tbitson/Teensy-GEP/User Documentation/User Guide/Doc Resources/IMG_0637D.jpeg

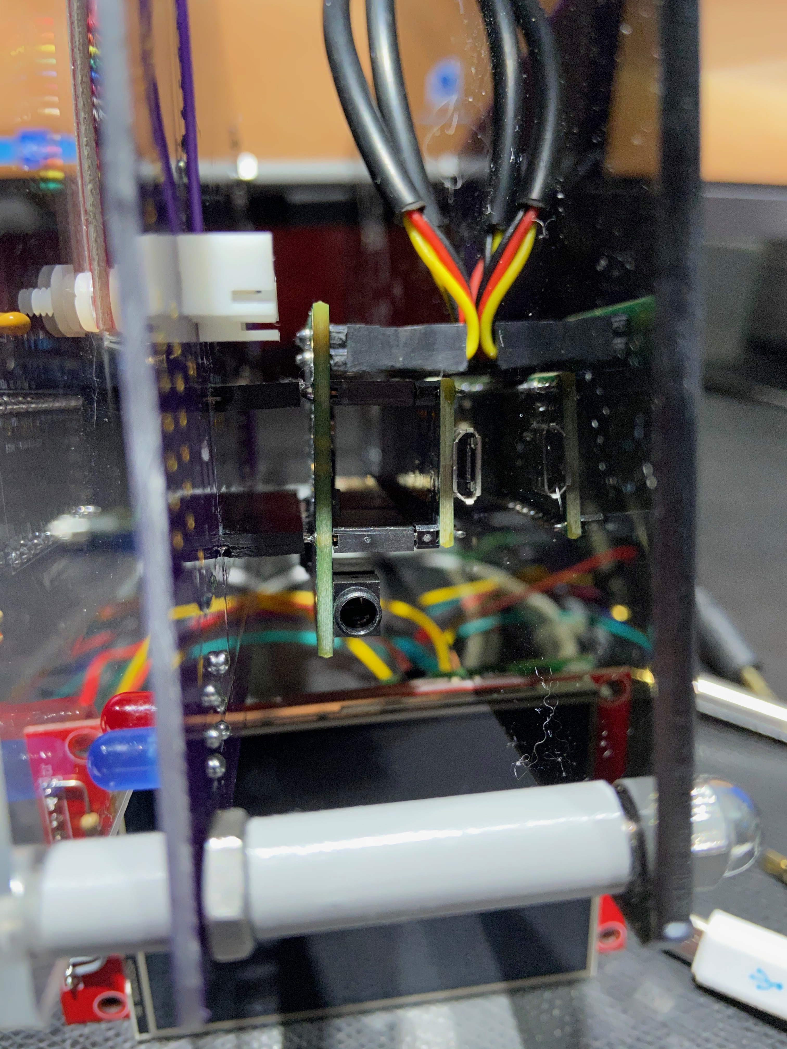
User Documentation/User Guide/Doc Resources/IMG_0637D.jpeg
