tbitson/Teensy-GEP/User Documentation/User Guide/Doc Resources/IMG_0635D.jpeg

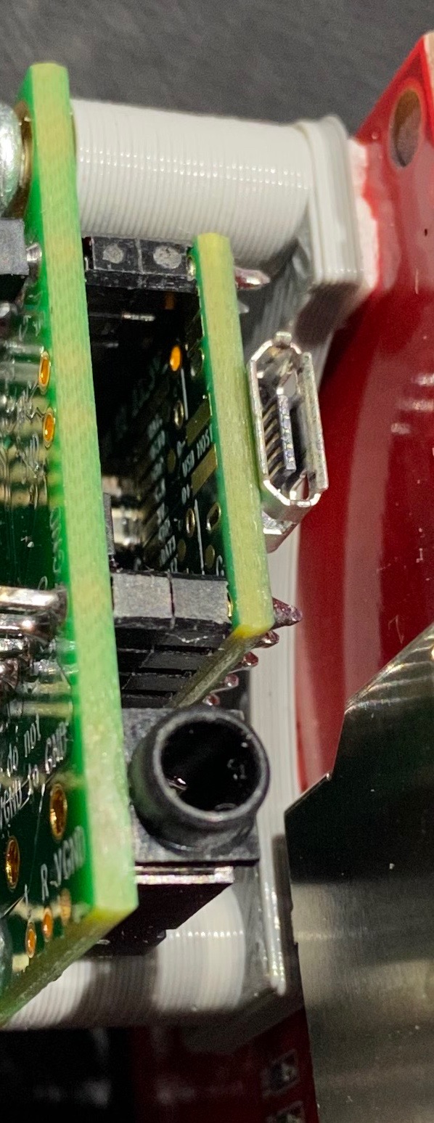
User Documentation/User Guide/Doc Resources/IMG_0635D.jpeg
