tbitson/Teensy-GEP/README.md

# Teensy-GEP
 Teensy Guitar Effects Processor
