tbitson/Teensy-GEP/Audio Shield Docs & Tools/Audio GUI Tool (modified)/README.md

This version of the audio tools includes an
added 8-channel mixer that is not part of the
Teensy Audio Library distribution. The cooresponding
audio library is included the GEP software folder
