tbitson/Teensy-GEP/Audio Shield Docs & Tools/Audio Lib Docs/8.6 FreeverbStereo Function.md

AudioEffectFreeverbStereo
Summary
High quality stereo Reverb effect, based on Freeverb by Jezar at Dreampoint.

Teensy 3.5 or 3.6 required to run stereo version.

Audio Connections
Port	Purpose
In 0	Input
Out 0	Left Output
Out 1	Right Output
Functions
roomsize(amount);
Sets the amount of reverberant echo or apparent room size, from 0 (smallest) to 1.0 (largest);
damping(amount);
Sets the damping factor, from 0 to 1.0. More damping causes higher frequency echo to decay, creating a softer sound, similar to a large room filled with people or materials which absorb some sound as it travels between reflecting surfaces. Lower damping simulates a harsher reverberant field.
Examples
File > Examples > Audio > Effects > Freeverb_Stereo
Notes
Freeverb mono consumes about 18% of the CPU time on Teensy 3.6 and requires about 45K of RAM.

Teensy 3.2 does not have enough RAM to run this effect while playing WAV file and implementing USB Serial.
