tbitson/Teensy-GEP/Audio Shield Docs & Tools/Audio Lib Docs/8.8 Multiply Function.md

AudioEffectMultiply
Summary
Multiply two signals together, useful for amplitude modulation or "voltage controlled amplification".

56 Hz and 1 kHz sine waves multiplied.

Audio Connections
Port	Purpose
In 0	Signal Input
In 1	Signal Input
Out 0	Signal with Envelope Applied
Functions
There are no functions to call from the Arduino sketch. This object simply multiplies the 2 signals to create a continuous output

Notes
