tbitson/Teensy-GEP/Reference Docs/Teensy Pinout Comparison.xlsx

Physical | Teensy 3.2 |  | Teensy 3.6 |  | Teensy 4.0 |  | Audio Sheild |  | 3 to 4 swap |  | LCD Connections |  |  |  | GEP Connections
Pin | I/O # | Pri Func | I/O # | Pri Func | I/O # | Pri Func | Rev c | Rev D | Rev D |  | 3.x | 4.0 | I/O # | Pri Func | 3.x | 4.0
1 |  | GND |  |  |  |  |  |  |  |  | GND | GND
2 | 0 | RX1 | 0 |  |  |  |  |  |  |  |  |  | 0 | D0/RX1 | Tuner Switch
3 | 1 | TX1 | 1 |  |  |  |  |  |  |  |  |  | 1 | D1/TX1 | Enc1 Pin 1
4 | 2 | D2 | 2 |  |  |  |  |  |  |  |  |  | 2 | D2 | Enc1 Pin 2
5 | 3 | D3 | 3 |  |  |  |  |  |  |  |  |  | 3 | D3 | Test LED
6 | 4 | D4 | 4 |  |  |  |  |  |  |  |  |  | 4 | D4 | Enc 2 Pin 1
7 | 5 | D5 | 5 |  |  |  |  |  |  |  |  | TFT_DC | 5 | D5 | Enc2 Pin 2 | TFT_DC
8 | 6 | D6 | 6 |  |  |  | SRAM CS | SRAM CS | NC |  |  |  | 6 | D6 | Audio Board
9 | 7 | D7 | 7 |  |  |  | SPI DI | DIN | 7 to 11 |  |  |  | 7 | D7 | Audio Board
10 | 8 | D8 | 8 |  |  |  |  | DOUT |  | from 8 | TS_CS |  | 8 | D8 | TS_CS
11 | 9 | D9 | 9 |  |  |  | BCLK |  | 9 to 21 |  |  | TS_CS | 9 | D9 | Audio Board | TS_CS
12 | 10 | SPI CS | 10 |  |  |  | SD CS | SD CS | NC |  |  |  | 10 | SPI CS | Audio Board
13 | 11 | SPI DO | 11 |  |  |  | MCLK | SPI DI | 11 to 23 |  | TFT_MOSI | TFT_MOSI | 11 | SPI DO | TFT_MOSI | TFT_MOSI
14 | 12 | SPI DI | 12 |  |  |  | SPI DO | SPI DO | NC |  | TFT_SDO | TFT_SDO | 12 | SPI DI | TFT_SDO | TFT_SDO
15 | 13 | SPI SCK | 13 |  |  |  | DOUT | SCLK | 13 to 8 |  | TFT_SCK | TFT_SCK | 13 | SPI SCK | TFT_SCK | TFT_SCK
16 | 14 | A0 | 14 |  |  |  | SCLK |  | 14 to 13 |  |  | TFT_CS | 14 | A0 | Audio Board | TFT_CS
17 | 15 | A1 | 15 |  |  |  | Pot V | Pot V | NC |  |  |  | 15 | A1 | Wah-Wah Pot
18 | 16 | A2 | 16 |  |  |  |  |  | --- |  | TS_IRQ* | TS_IRQ* | 16 | A2 | Mix Pot | TS_IRQ
19 | 17 | A3 | 17 |  |  |  |  |  | --- |  |  |  | 17 | A3 | Save Switch
20 | 18 | A4 | 18 |  |  |  | SDA | SDA | NC |  |  |  | 18 | A4 | I2C
21 | 19 | A5 | 19 |  |  |  | SCL | SCL | NC |  |  |  | 19 | A5 | I2C
22 | 20 | A6 | 20 |  |  |  |  | LRCLK |  | from 23 | TFT_DC |  | 20 | A6 | TFT_DC
23 | 21 | A7 | 21 |  |  |  |  | BCLK |  | from 9 | TFT_CS |  | 21 | A7 | TFT_CS
24 | 22 | A8 | 22 |  |  |  | DIN |  | 22 to 7 |  |  |  | 22 | A8 | Audio Board
25 | 23 | A9 | 23 |  |  |  | LRCLK | MCLK | 23 to 20 |  |  |  | 23 | A9 | Audio Board
26 |  | 3.3V |  |  |  |  | 3.3V | 3.3V |  |  | TFT_VCC | TFT_VCC
27 |  | AGND |  |  |  |  | AGND | AGND
28 |  | Vin |  |  |  |  |  |  |  |  | TFT_LED | TFT_LED | Thru 100Ω resistor | TFT_LED | TFT_LED
 |  |  |  |  |  |  | 13 | 13 |  |  | TFT_RESET | TFT_RESET | 255 | TFT_RESET | TFT_RESET
 |  |  |  |  |  |  |  |  |  |  | * = optional
3.x LCD Defines |  |  | 4.0 LCD Defines |  |  |  |  |  |  | LCD Connections
No Audio Board |  |  |  |  |  |  |  |  | Phys Pin | Label | LCD Func | Teensy 3.x Pin | Teensy 4.0 Pin |  |  |  | // T_DO: connected to TFT_SDO on the screen
#define TS_IRQ 16 |  |  | With Audio Board |  |  |  |  |  | 1 | VCC | +3.3V | +3.3 | +3.3 |  |  |  | // T_DIN: connected to TFT_MOSI on the screen
#define TS_CS 8 |  |  | // Screen |  |  |  |  |  | 2 | GND | GND | GND | GND |  |  |  | // T_CLK: connected to TFT_SCK on the screen
// Screen |  |  | #define TFT_DC 5 |  |  |  |  |  | 3 | CS | TFT_CS | 21 | 14
#define TFT_SDO 12 |  |  | #define TFT_CS 14 |  |  |  |  |  | 4 | RESET | +3.3V | +3.3 | +3.3
#define TFT_SCK 14 |  |  | #define TFT_SDO 12 |  |  |  |  |  | 5 | DC | TFT_DC | 20 | 5
#define TFT_MOSI 7 |  |  | #define TFT_SCK 13 |  |  |  |  |  | 6 | SDI | TFT_SDI | 7 | 11
#define TFT_DC 20 |  |  | #define TFT_MOSI 11 |  |  |  |  |  | 7 | SCK | TFT_SCK | 14 | 13
#define TFT_RST 255 |  |  | #define TFT_RST 255 |  |  |  |  |  | 8 | LED | LED Power | 100Ω to +5v | 100Ω to +5v
#define TFT_CS 21 |  |  |  |  |  |  |  |  | 9 | SDO | TFT_SDO | 12 | 12
 |  |  | // Touch |  |  |  |  |  | 10 | T_CLK | TS_CLK | 14* | 13*
Teensy GEP |  |  | #define TS_IRQ 16 |  |  |  |  |  | 11 | T_CS | TS_CS | 8 | 9
#define TFT_DC 20 |  |  | #define TS_CS 9 |  |  |  |  |  | 12 | T_DIN | TS_DIN | 11* | 11*
#define TFT_CS 21 |  |  |  |  |  |  |  |  | 13 | T_DO | TS_DO | 12* | 12*
#define TFT_RST 255 |  |  |  |  |  |  |  |  | 14 | T_IRQ | TS_IRQ (Optional) | 16 | 16
#define TFT_MOSI 7
#define TFT_SCLK 14 |  |  |  |  |  |  |  |  |  |  |  | * shared pin on Teensy
#define TFT_MISO 12
#define TS_CS
#define TS_IRG
