tbitson/Teensy-GEP/GEP Hardware/Hardware Design Files/Teensy Audio Pin Map.xlsx

Sheet: Sheet1_2
 | Teensy Pedal Pin assignment
Pin | Description | opt/unused | Comments
 | Encoder / RG led |  |  | Row1 | Type | Connected to | Opt/unused | Row2 | Type | Connected to | Opt/unused
24 | ENC_SW | no | D in pullup | GND |  |  |  | Vin
25 | ENC_A | no | D in pullup | 0 | D | #N/A | #N/A | A GND | OUT | #N/A | #N/A
26 | ENC_B | no | D in pullup | 1 | D | #N/A | #N/A | 3.3V 250 ma | OUT | #N/A | #N/A
29 | ENC_Rled | y | PWM | 2 | D | #N/A | #N/A | 23 | A | DACL/ADCL i2s | no
30 | ENC_Gled | y | PWM | 3 | D | #N/A | #N/A | 22 | A | MOSI i2s | no
 | Pots |  |  | 4 | D | #N/A | #N/A | 21 | A | TFT_CS | no
36 | Pot1 | no | analog in | 5 | D | #N/A | #N/A | 20 | A | TFT_DC | no
37 | Pot2 | no | analog in | 6 | D | #N/A | #N/A | 19 | A | SCL i2c | no
38 | Pot3 | no | analog in | 7 | D | TFT_MOSI | no | 18 | A | SDA i2c | no
39 | Pot4 | no | analog in | 8 | D | #N/A | #N/A | 17 | A | #N/A | #N/A
 | Switches |  |  | 9 | D | SCK i2s | no | 16 | A | #N/A | #N/A
27 | SW1 | no |  | 10 | D | #N/A | #N/A | 15 | A | #N/A | #N/A
28 | SW2 | no |  | 11 | D | #N/A | #N/A | 14 | A | TFT_SCLK | no
31 | SW3 | y |  | 12 | D | TFT_MISO | no | 13 (LED) | D | #N/A | #N/A
 | TFT ILI9341 2.2’’ |  |  | 3.3V | OUT | #N/A | #N/A | Gnd | OUT | #N/A | #N/A
20 | TFT_DC | no |  | 24 | D | ENC_SW | no | Dac1 | OUT | #N/A | #N/A
21 | TFT_CS | no |  | 25 | D | ENC_A | no | Dac0 | OUT | #N/A | #N/A
3.3V | TFT_RST |  |  | 26 | D | ENC_B | no | 39 | A | Pot4 | no
7 | TFT_MOSI | no |  | 27 | D | SW1 | no | 38 | A | Pot3 | no
14 | TFT_SCLK | no |  | 28 | D | SW2 | no | 37 | A | Pot2 | no
12 | TFT_MISO | no |  | 29 | D | ENC_Rled | y | 36 | A | Pot1 | no
 | (remaining connections : VCC=> 5V, GND to GND, LED to 5V through 100ohm res) |  |  | 30 | D | ENC_Gled | y | 35 | A | #N/A | #N/A
 | Audio CODEC WM8731 MikroElectronika |  |  | 31 | D | SW3 | y | 34 | A | #N/A | #N/A
23 | DACL/ADCL i2s | no |  | 32 | D | #N/A | #N/A | 33 | A | #N/A | #N/A
22 | MOSI i2s | no
13 | MISO i2s | no |  | BACK |  |  |  | BACK
9 | SCK i2s | no |  | AREF |  |  |  | USBHOST
18 | SDA i2c | no |  | A10 |  |  |  | USBHOST
19 | SCL i2c | no |  | A11 |  |  |  | USBHOST
 |  |  |  | 57 |  |  |  | USBHOST
 |  |  |  | 56 |  |  |  | USBHOST
 |  |  |  | 55 |  |  |  | GND
 |  |  |  | 54 |  |  |  | DE
 |  |  |  | 53 |  |  |  | DC
 |  |  |  | 52 |  |  |  | DD
 |  |  |  | 51 |  |  |  | 40
 |  |  |  | 50 |  |  |  | 41
 |  |  |  | 49 |  |  |  | 42
 |  |  |  | 48 |  |  |  | 43
 |  |  |  | 47 |  |  |  | 44
 |  |  |  | 3.3V |  |  |  | 45
 |  |  |  |  |  |  |  | 46
 |  |  |  |  |  |  |  | GND

Sheet: Sheet1
 | Teensy Pedal Pin assignment
Pin | Description | opt/unused | Comments
 | Encoder / RG led |  |  | Row1 |  |  |  | Row2
0 | ENC_SW | no |  | GND | Type | Connected to | Opt/unused | Vin | Type | Connected to | Opt/unused
2 | ENC_A | no |  | 0 | D | ENC_SW | no | A GND | OUT | #N/A | #N/A
3 | ENC_B | no |  | 1 | D | SW1 | no | 3.3V 250 ma | OUT | #N/A | #N/A
 | ENC_Rled | y |  | 2 | D | ENC_A | no | 23 | A | LRCLK i2s | no
 | ENC_Gled | y |  | 3 | D | ENC_B | no | 22 | A | TX i2s | no
 | Pots |  |  | 4 | D | SW2 | no | 21 | A | TFT_CS | no
 | Pot1 | no | analog | 5 | D | SW3 | y | 20 | A | TFT_DC | no
 | Pot2 | no | analog | 6 | D | MEMCS (opt) | y | 19 | A | SCL i2c | no
 | Pot3 | no | analog | 7 | D | TFT_MOSI | no | 18 | A | SDA i2c | no
 | Pot4 | no | analog | 8 | D | #N/A | #N/A | 17 | A | #N/A | #N/A
 | Switches |  |  | 9 | D | BCLK i2s | no | 16 | A | #N/A | #N/A
1 | SW1 | no |  | 10 | D | SDCS | y | 15 | A | Vol pot | y
4 | SW2 | no |  | 11 | D | MCLK i2s | no | 14 | A | TFT_SCLK | no
5 | SW3 | y |  | 12 | D | TFT_MISO | no | 13 (LED) | D | #N/A | #N/A
 | TFT ILI9341 2.2’’ |  |  | 3.3V | OUT | #N/A | #N/A | Gnd | OUT | #N/A | #N/A
20 | TFT_DC | no |  | 24 | D | #N/A | #N/A | Dac1 | OUT | #N/A | #N/A
21 | TFT_CS | no |  | 25 | D | #N/A | #N/A | Dac0 | OUT | #N/A | #N/A
3.3V | TFT_RST |  |  | 26 | D | #N/A | #N/A | 39 | A | #N/A | #N/A
7 | TFT_MOSI | no |  | 27 | D | #N/A | #N/A | 38 | A | #N/A | #N/A
14 | TFT_SCLK | no |  | 28 | D | #N/A | #N/A | 37 | A | #N/A | #N/A
12 | TFT_MISO | no |  | 29 | D | #N/A | #N/A | 36 | A | #N/A | #N/A
 | (remaining connections : VCC=> 5V, GND to GND, LED to 5V through 100ohm res) |  |  | 30 | D | #N/A | #N/A | 35 | A | #N/A | #N/A
 | Audio Shield |  |  | 31 | D | #N/A | #N/A | 34 | A | #N/A | #N/A
6 | MEMCS (opt) | y | pull up to 3.3V 10kOhm | 32 | D | #N/A | #N/A | 33 | A | #N/A | #N/A
7 | MOSI SD | shared SPI | (MOSI)
10 | SDCS | y | (SDCS) pull up to 3.3V 10kOhm | BACK |  |  |  | BACK
12 | MISO SD | shared SPI | (MISO) | AREF |  |  |  | USBHOST
14 | SCLk SD | shared SPI | (SCLK) | A10 |  |  |  | USBHOST
15 | Vol pot | y | (analog input) | A11 |  |  |  | USBHOST
23 | LRCLK i2s | no |  | 57 |  |  |  | USBHOST
22 | TX i2s | no |  | 56 |  |  |  | USBHOST
13 | RX i2s | no |  | 55 |  |  |  | GND
11 | MCLK i2s | no |  | 54 |  |  |  | DE
9 | BCLK i2s | no |  | 53 |  |  |  | DC
18 | SDA i2c | no |  | 52 |  |  |  | DD
19 | SCL i2c | no |  | 51 |  |  |  | 40
 |  |  |  | 50 |  |  |  | 41
 |  |  |  | 49 |  |  |  | 42
 |  |  |  | 48 |  |  |  | 43
 |  |  |  | 47 |  |  |  | 44
 |  |  |  | 3.3V |  |  |  | 45
 |  |  |  |  |  |  |  | 46
 |  |  |  |  |  |  |  | GND
