tbitson/Teensy-GEP/GEP Hardware/Hardware Design Files/Teensy IO Functions.xlsx

GEP |  | Secondary | Primary | Physical | Physical | Primary | Secondary | GEP
Function |  | Function | Function | Pin | Pin | Function | Function | Function |  | Teensy 3.2 IO
 |  |  | GND | 1 | 28 | Vin |  |  |  | Primary | Alt | Function | GEP Function
 | Tuner PB Switch | RX1 | D0 | 2 | 27 | AGND
 | Param Rot Encoder A | TX1 | D1 | 3 | 26 | 3.3V |  |  |  | D0 | Rx |  | Tuner PB Switch
 | Param Rot Encoder B |  | D2 | 4 | 25 | D23/A9 | Touch | Audio L/R Clock |  | D1 | Tx |  | Param Rotary Encoder A
 | LCD Reset |  | D3 | 5 | 24 | D22/A8 | Touch | Audio Data from Teensy |  | D2 |  |  | Param Rotary Encoder B
 | Value Rotary Encoder A |  | D4 | 6 | 23 | D21/A7 |  | LCD CS |  | D3 |  | Serial Tx | LCD Reset
 | Value Rotary Encoder B |  | D5 | 7 | 22 | D20/A6 |  | LCD D/C |  | D4 |  | Serial Rx | Value Rotary Encoder A
Audio CS for Mem |  |  | D6 | 8 | 21 | D19/A5 | SCL0 | PCF8574N I2C SCL | Audio Control Clock | D5 |  |  | Value Rotary Encoder B
SPI to SD/Mem | LCD SPI MOSI, LCD TS DIN |  | D7 | 9 | 20 | D18/A4 | SDA0 | PCF8574N I2C SDA | Audio Control Data | D6
 | LCD Touch CS |  | D8 | 10 | 19 | D17/A3 |  | Save PB Switch |  | D7 |  | SPI 2 MOSI | LCD SPI MOSI, LCD TS DIN
 | Audio Bit Clock |  | D9 | 11 | 18 | D16/A2 |  | Effects Mix Pot Input |  | D8 |  | SPI 2 MISO | LCD Touch CS
 | Compressor Toggle Switch | CS | D10 | 12 | 17 | D15/A1 |  | Pedal Pot Input | Audio Thumbwheel Pot | D9 |  | SPI 2 CS
Audio CS for SD | Audio Master Clock | DOUT | D11 | 13 | 16 | D14/A0 |  | LCD SPI SCLK, LCD TS SCLK | SD SPI Clock | D10 |  | SPI 1 CS | Compressor Toggle Switch
Audio SPI from SD/Mem | LCD SPI MISO | DIN | D12 | 14 | 15 | D13 | SCLK | Audio Data to Teensy |  | D11 |  | SPI 1 MOSI
 |  |  |  |  |  |  |  |  |  | D12 |  | SPI 1 MISO | LCD SPI MISO
 |  |  |  | Teensy 3.2 / 3.5 / 3.6 |  |  |  |  |  | D13 | LED | SPI 1 SCLK
 |  |  |  |  |  |  |  |  |  | D14 | A0 | SPI 2 SCK | LCD SPI SCLK, LCD TS SCLK
 |  |  |  |  |  |  |  |  |  | D15 | A1 |  | Pedal Pot Input
 |  |  |  |  |  |  |  |  |  | D16 | A2 |  | Effects Mix Pot Input
 |  |  |  |  |  |  |  |  |  | D17 | A3 |  | Save PB Switch
 |  |  |  |  |  |  |  |  |  | D18 | A4 | I2C SDA | PCF8574N I2C SDA
 |  |  |  |  |  |  |  |  |  | D19 | A5 | I2C SCL | PCF8574N I2C SCL
 |  |  |  |  |  |  |  |  |  | D20 | A6 |  | LCD D/C
 |  |  |  |  |  |  |  |  |  | D21 | A7 |  | LCD CS
 |  |  |  |  |  |  |  |  |  | D22 | A8
 |  |  |  |  |  |  |  |  |  | D23 | A9
