tbitson/Teensy-GEP/Audio Shield Docs & Tools/Audio Lib Docs/10.1 Audio Analyze Peak.md

Type	 AudioAnalyzePeak
ID	 peak1
 Properties
 name	peak1

Summary
Track the signal peak amplitude. Very useful for simple audio level response projects, and general troubleshooting.

Audio Connections
Port	Purpose
In 0	Signal to analyze
Functions
available();
Returns true each time new peak data is available.
read();
Read the highest peak amplitude value since the last read. Return is from 0.0 to 1.0.
readPeakToPeak();
Read the highest peak-to-peak amplitude since the last read. Return is from 0.0 to 2.0.
Examples
File > Examples > Audio > Analysis > PeakMeterMono
File > Examples > Audio > Analysis > PeakMeterStereo
Notes
