tbitson/Teensy-GEP/Audio Shield Docs & Tools/Audio Lib Docs/1. Audio Control.png

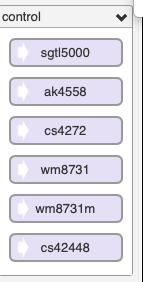
Audio Shield Docs & Tools/Audio Lib Docs/1. Audio Control.png
