tbitson/Teensy-GEP/Audio Shield Docs & Tools/Audio Lib Docs/2. Input.png

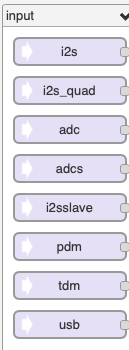
Audio Shield Docs & Tools/Audio Lib Docs/2. Input.png
