tbitson/Teensy-GEP/Audio Shield Docs & Tools/Audio Lib Docs/3. Output.png

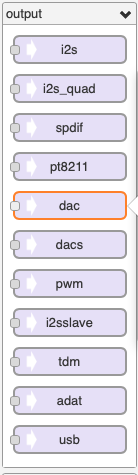
Audio Shield Docs & Tools/Audio Lib Docs/3. Output.png
