tbitson/Teensy-GEP/Audio Shield Docs & Tools/Audio Lib Docs/5. Play.png

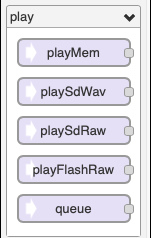
Audio Shield Docs & Tools/Audio Lib Docs/5. Play.png
