tbitson/Teensy-GEP/Audio Shield Docs & Tools/Audio Lib Docs/7. Synthesizer.png

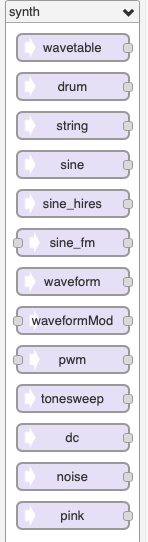
Audio Shield Docs & Tools/Audio Lib Docs/7. Synthesizer.png
