tbitson/Teensy-GEP/Audio Shield Docs & Tools/Audio Lib Docs/8. Effects.png

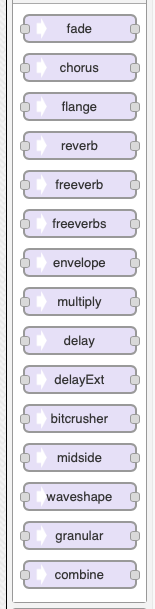
Audio Shield Docs & Tools/Audio Lib Docs/8. Effects.png
