tbitson/Teensy-GEP/Audio Shield Docs & Tools/Audio Lib Docs/9. Filters.png

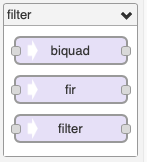
Audio Shield Docs & Tools/Audio Lib Docs/9. Filters.png
