tbitson/Teensy-GEP/Audio Shield Docs & Tools/Audio Lib Docs/10. Analyze.png

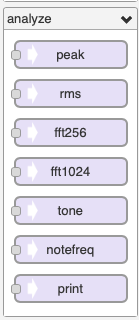
Audio Shield Docs & Tools/Audio Lib Docs/10. Analyze.png
