tbitson/Teensy-GEP/GEP Hardware/GEP Analog Board Schematic.png

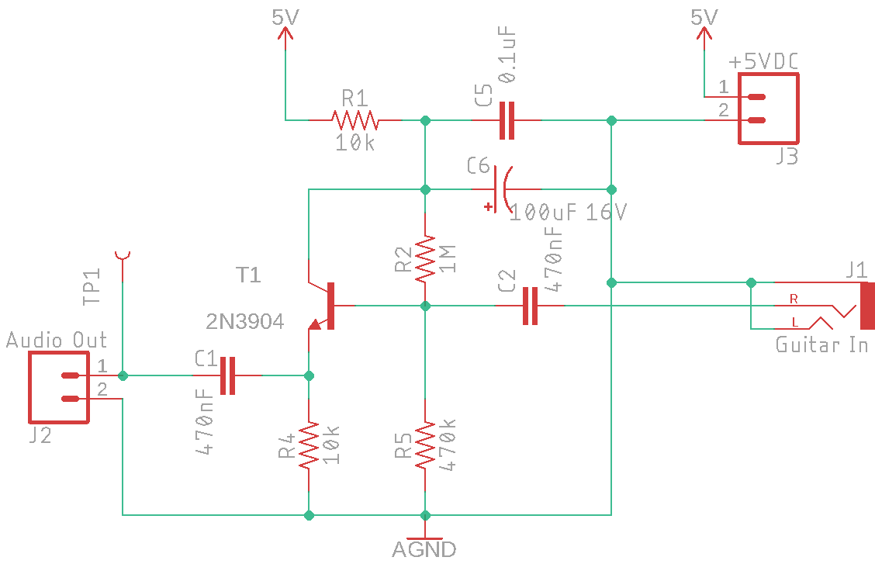
GEP Hardware/GEP Analog Board Schematic.png
