tbitson/Teensy-GEP/GEP Hardware/GEP Digital Board Schematic.png

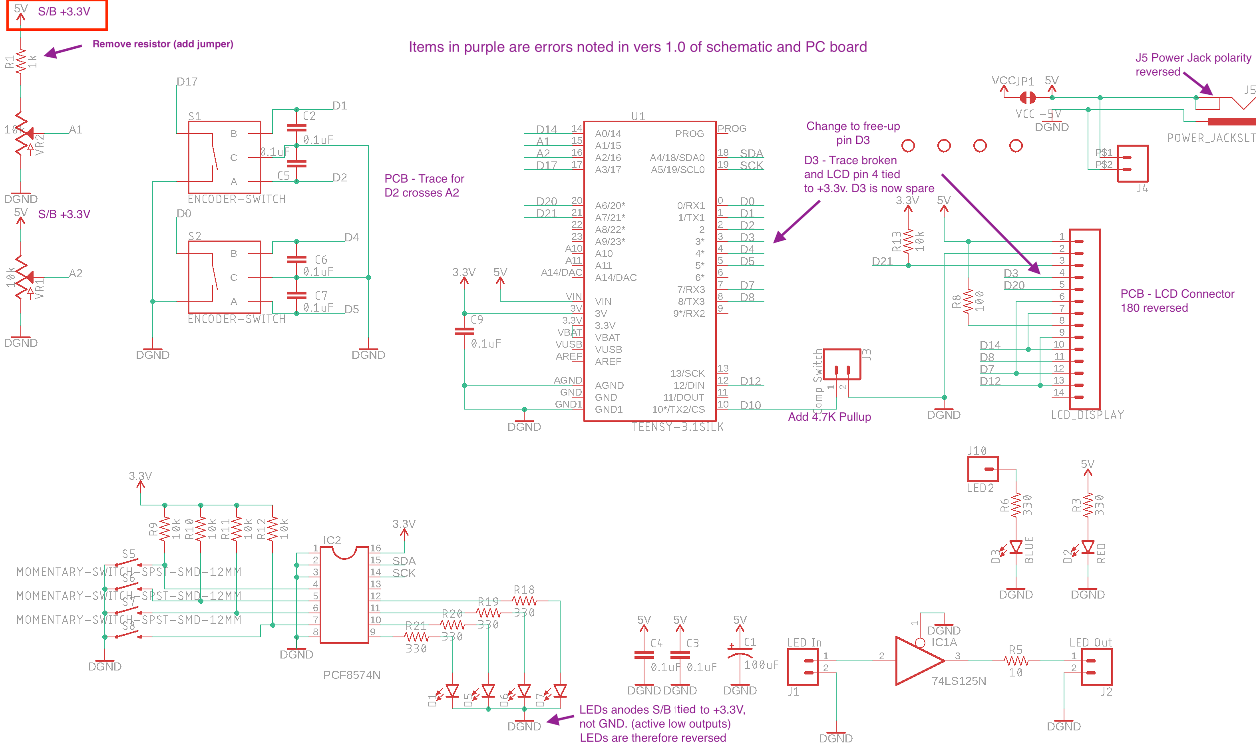
GEP Hardware/GEP Digital Board Schematic.png
