tbitson/Teensy-GEP/GEP Hardware/GEP PCB Layout.png

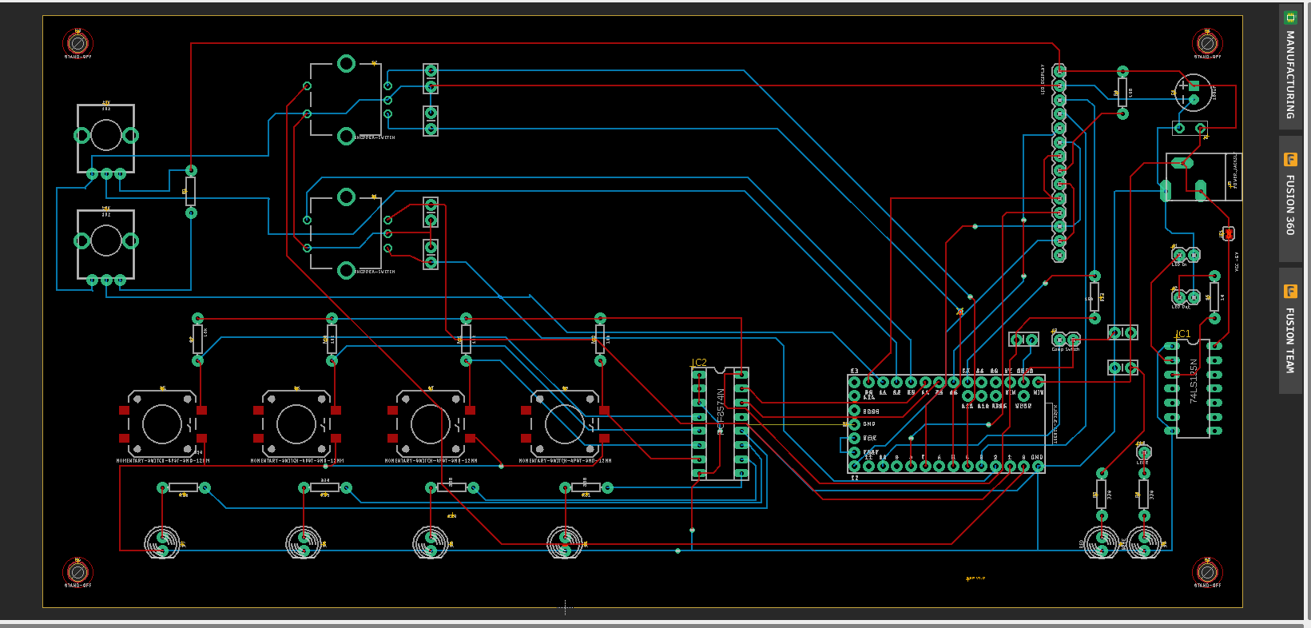
GEP Hardware/GEP PCB Layout.png
