tbitson/Teensy-GEP/GEP Hardware/Hardware Design Files/LCD Display/display_ili9341_touch_drawing.png

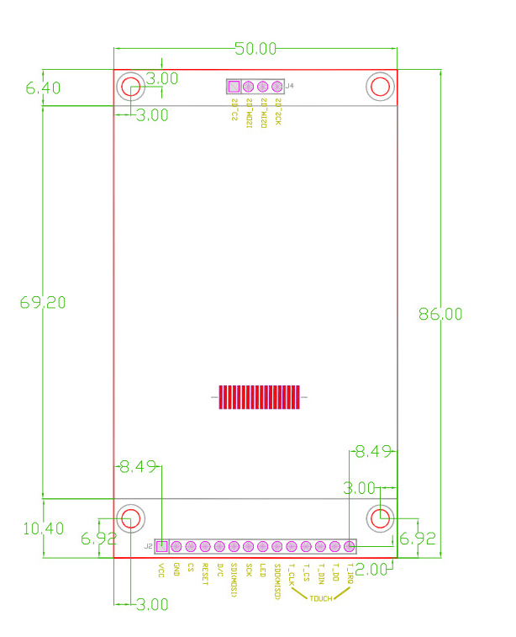
GEP Hardware/Hardware Design Files/LCD Display/display_ili9341_touch_drawing.png
