tbitson/Teensy-GEP/GEP Hardware/Hardware Design Files/LCD Display/Teensy LCD Connections.png

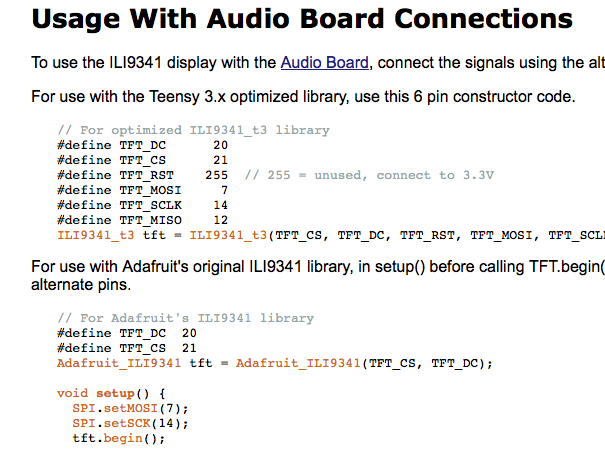
GEP Hardware/Hardware Design Files/LCD Display/Teensy LCD Connections.png
