tbitson/Teensy-GEP/GEP Hardware/Hardware Design Files/LCD Display/Teensy LCD Pinout.png

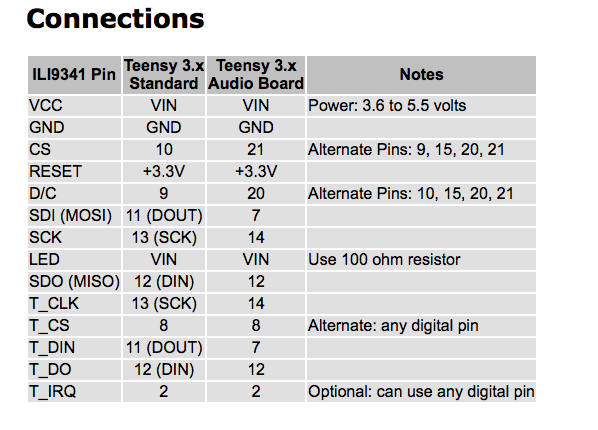
GEP Hardware/Hardware Design Files/LCD Display/Teensy LCD Pinout.png
