tbitson/Teensy-GEP/GEP Hardware/Hardware Design Files/Teensy and Audio Board/Orig GEP Schematic.png

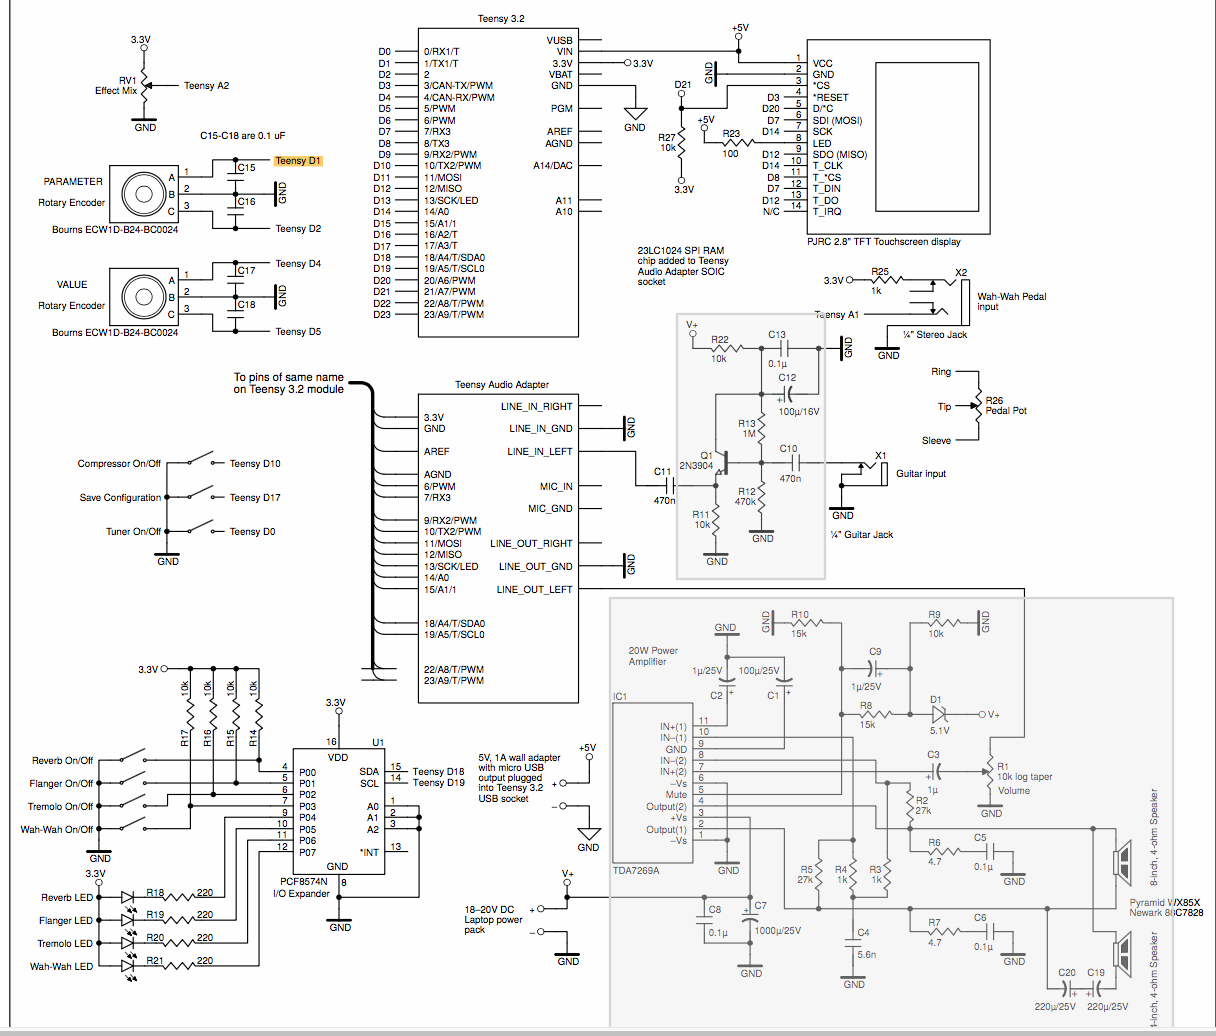
GEP Hardware/Hardware Design Files/Teensy and Audio Board/Orig GEP Schematic.png
