tbitson/Teensy-GEP/GEP Hardware/Hardware Design Files/Teensy and Audio Board/Teensy Image.png

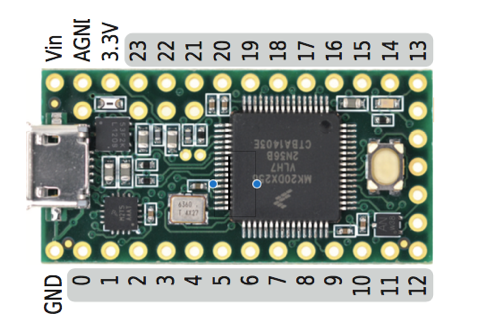
GEP Hardware/Hardware Design Files/Teensy and Audio Board/Teensy Image.png
