tbitson/Teensy-GEP/GEP Hardware/Original Pre-amp Schematic.png

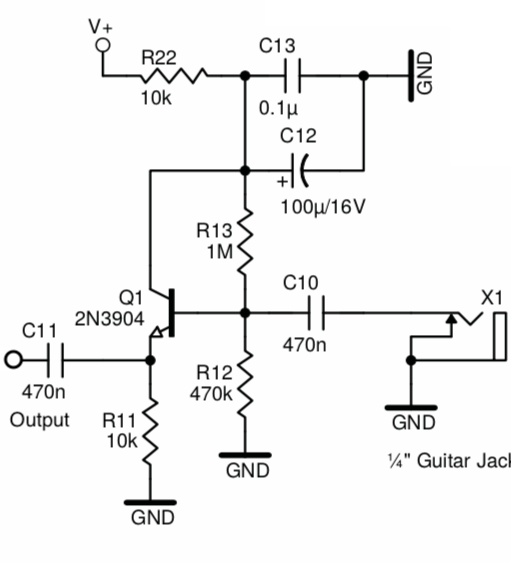
GEP Hardware/Original Pre-amp Schematic.png
