tbitson/Teensy-GEP/GEP Software/Support Files/Effects Development/Pass-Thru/Patches.png

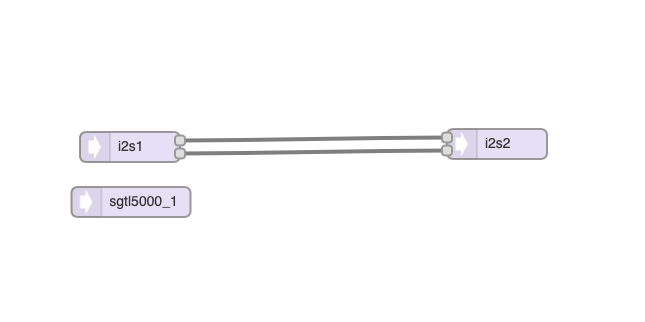
GEP Software/Support Files/Effects Development/Pass-Thru/Patches.png
