tbitson/Teensy-GEP/GEP Software/Support Files/Patchboards/Audio Patchboard vers 1.0.png

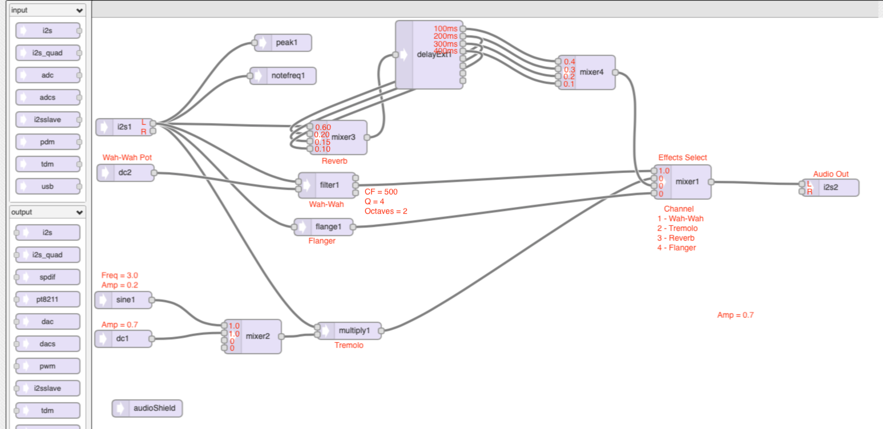
GEP Software/Support Files/Patchboards/Audio Patchboard vers 1.0.png
