tbitson/Teensy-GEP/GEP Software/Support Files/Patchboards/Patches V1.70.png

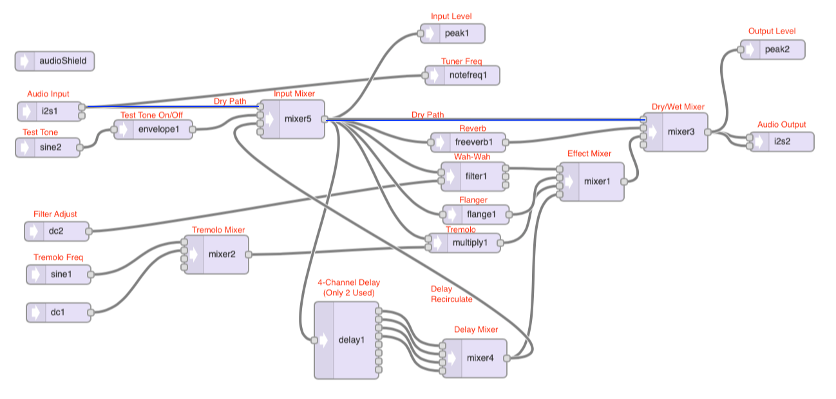
GEP Software/Support Files/Patchboards/Patches V1.70.png
