tbitson/Teensy-GEP/GEP Software/Support Files/Patchboards/v167 Patches.png

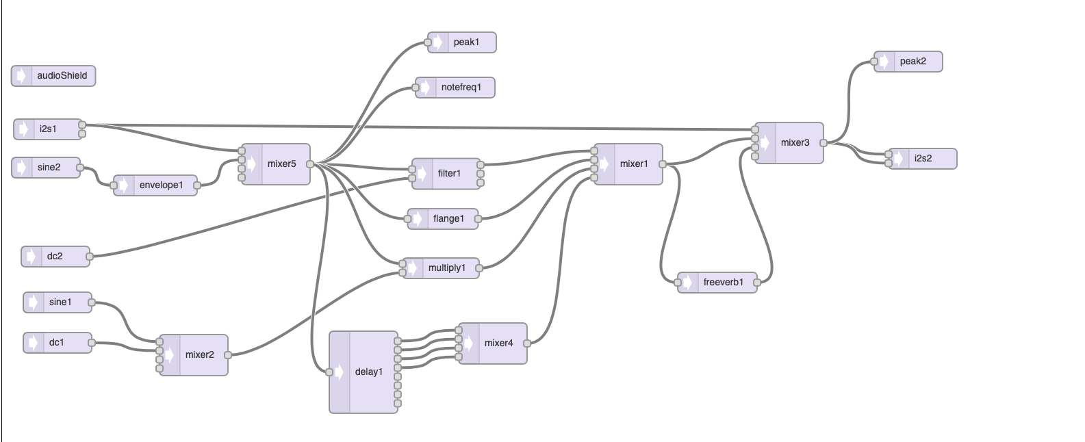
GEP Software/Support Files/Patchboards/v167 Patches.png
