tbitson/Teensy-GEP/GEP Software/Support Files/Patchboards/v167_tone patches.png

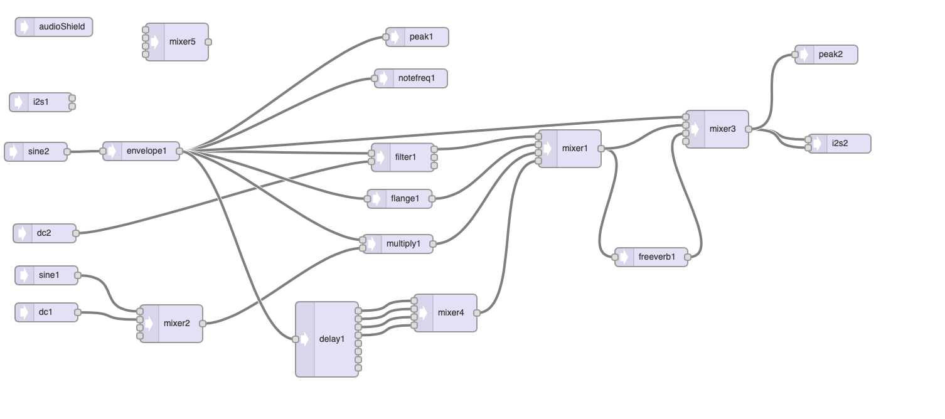
GEP Software/Support Files/Patchboards/v167_tone patches.png
