tbitson/Teensy-GEP/GEP Software/Support Files/Patchboards/v168 Patches.png

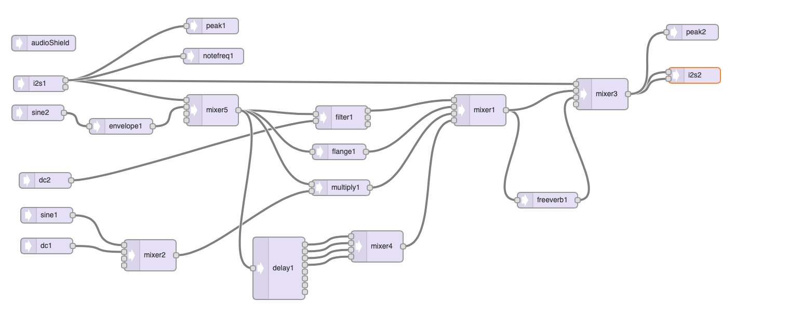
GEP Software/Support Files/Patchboards/v168 Patches.png
