tbitson/Teensy-GEP/GEP Software/Support Files/Patchboards/v169 Patches - annotated.png

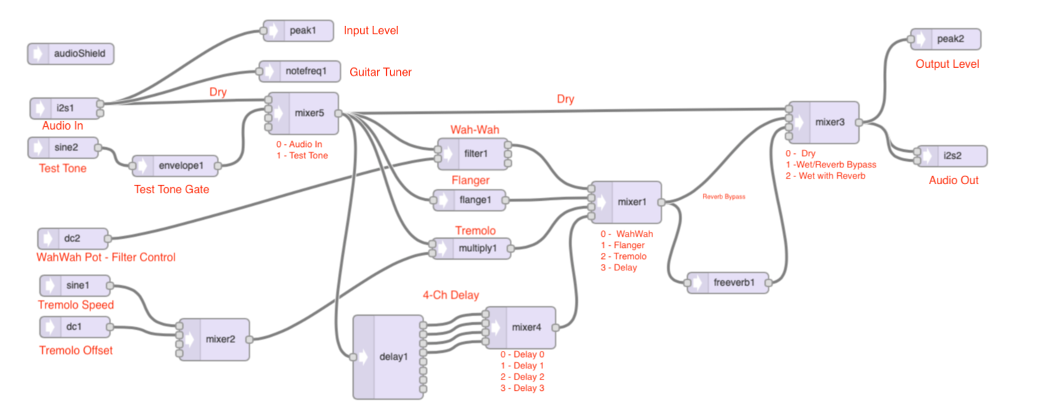
GEP Software/Support Files/Patchboards/v169 Patches - annotated.png
