tbitson/Teensy-GEP/GEP Software/Support Files/Patchboards/v169 Patches.png

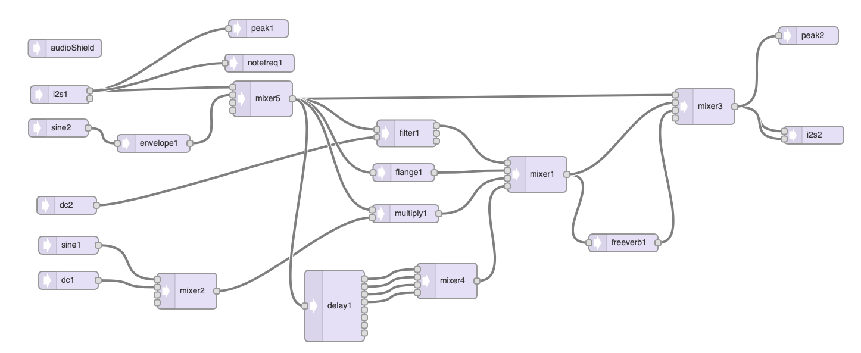
GEP Software/Support Files/Patchboards/v169 Patches.png
