tbitson/Teensy-GEP/Reference Docs/Audio Board Pin Comparison.png

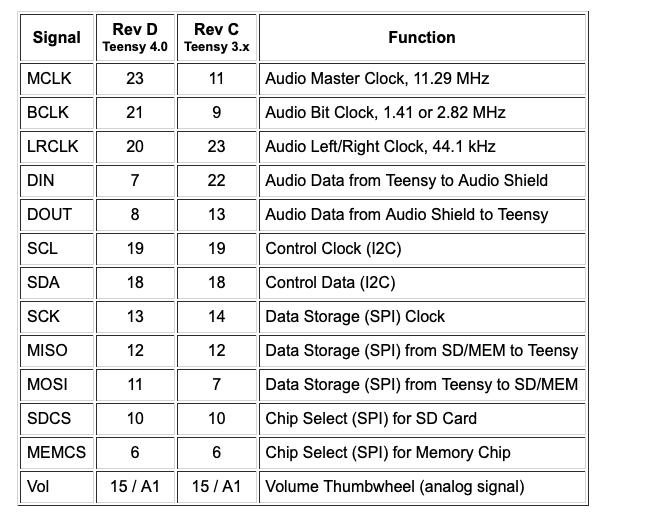
Reference Docs/Audio Board Pin Comparison.png
