tbitson/Teensy-GEP/GEP Hardware/GEP Teeny IO Functions.xlsx

Teensy 3.2 IO
Primary | Alt | Function | GEP Function
D0 | Rx |  | Tuner PB Switch
D1 | Tx |  | Param Rotary Encoder A
D2 |  |  | Param Rotary Encoder B
D3 |  | Serial Tx | LCD Reset
D4 |  | Serial Rx | Value Rotary Encoder A
D5 |  |  | Value Rotary Encoder B
D6
D7 |  | SPI 2 MOSI | LCD SPI MOSI, LCD TS DIN
D8 |  | SPI 2 MISO | LCD Touch CS
D9 |  | SPI 2 CS
D10 |  | SPI 1 CS | Compressor Toggle Switch
D11 |  | SPI 1 MOSI
D12 |  | SPI 1 MISO | LCD SPI MISO
D13 | LED | SPI 1 SCLK
D14 | A0 | SPI 2 SCK | LCD SPI SCLK, LCD TS SCLK
D15 | A1 |  | Pedal Pot Input
D16 | A2 |  | Effects Mix Pot Input
D17 | A3 |  | Save PB Switch
D18 | A4 | I2C SDA | PCF8574N I2C SDA
D19 | A5 | I2C SCL | PCF8574N I2C SCL
D20 | A6 |  | LCD D/C
D21 | A7 |  | LCD CS
D22 | A8
D23 | A9
