tbitson/Teensy-GEP/Audio Shield Docs & Tools/Teensy Audio Workshop Tutorial/dev files/Teensy Audio Hookup v2.pptx

## Teensy Audio Workshop – Part 1 Wiring Diagram

AIO 2

Vcc +3.3V

AIO 1 (unused)

AIO 3

Vin

AGnd

+3.3v

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
D13/LED

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
POT1

POT2

Gnd

DIO 0

DIO 1

Ground (GND)

DIO 2

Ground/Return

Vers 1.2 TAB

## Slide 2

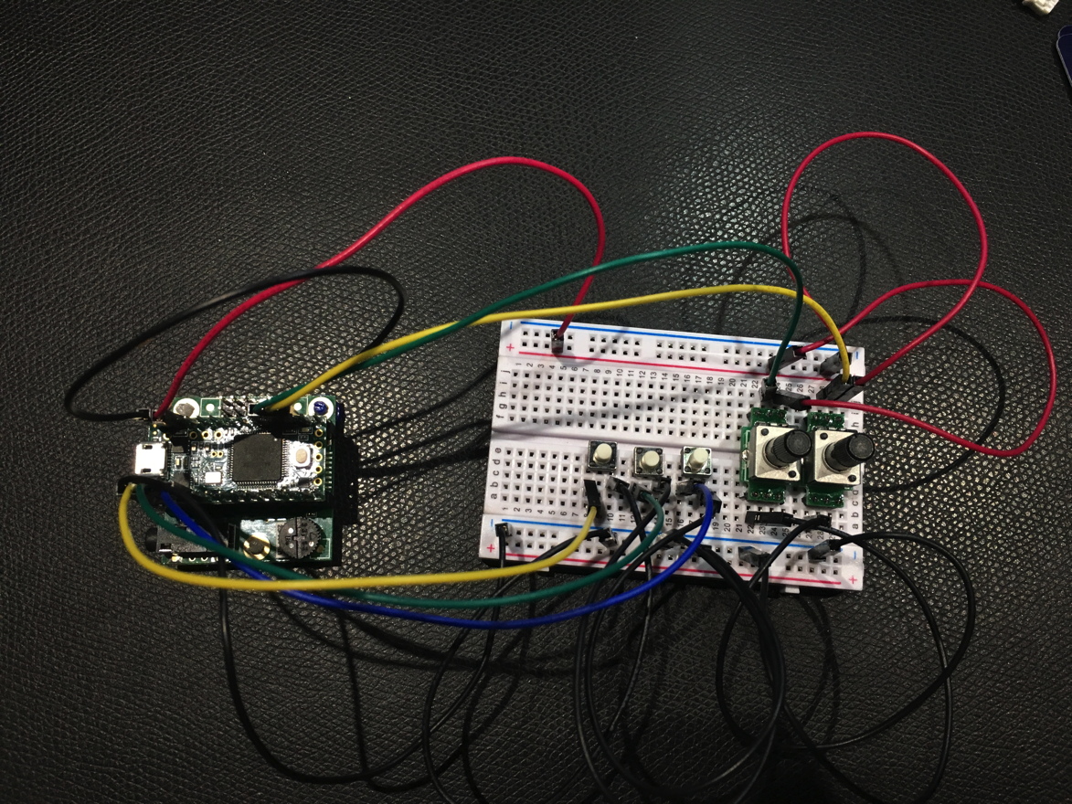
[picture p76: figure]
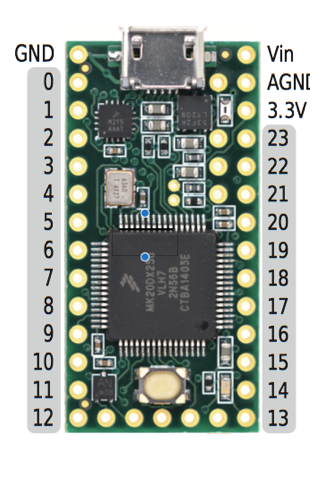
[picture p77: figure]
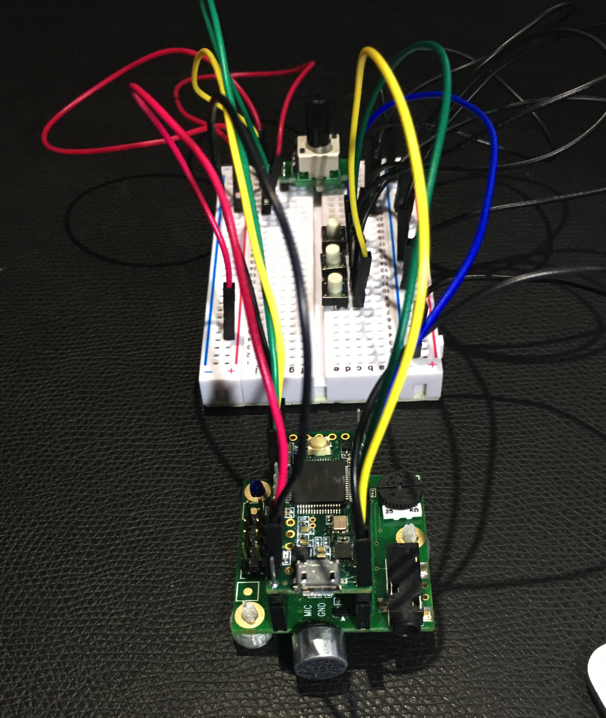
[picture p78: figure]
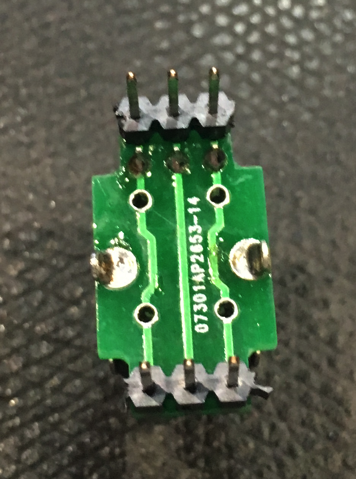
[picture p79: figure]
