tbitson/Teensy-GEP/User Documentation/User Guide/Doc Resources/GEP Front Panel.pdf

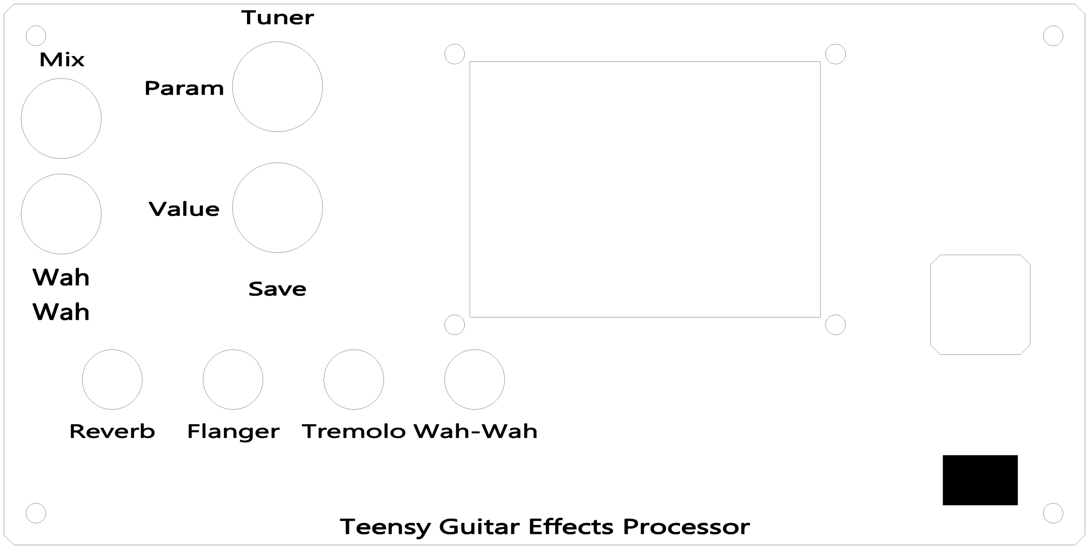
[picture p80: figure]
