tbitson/Teensy-GEP/Audio Shield Docs & Tools/Teensy Audio Workshop Tutorial/Audio Workshop Pt1 Wiring Diagram.png

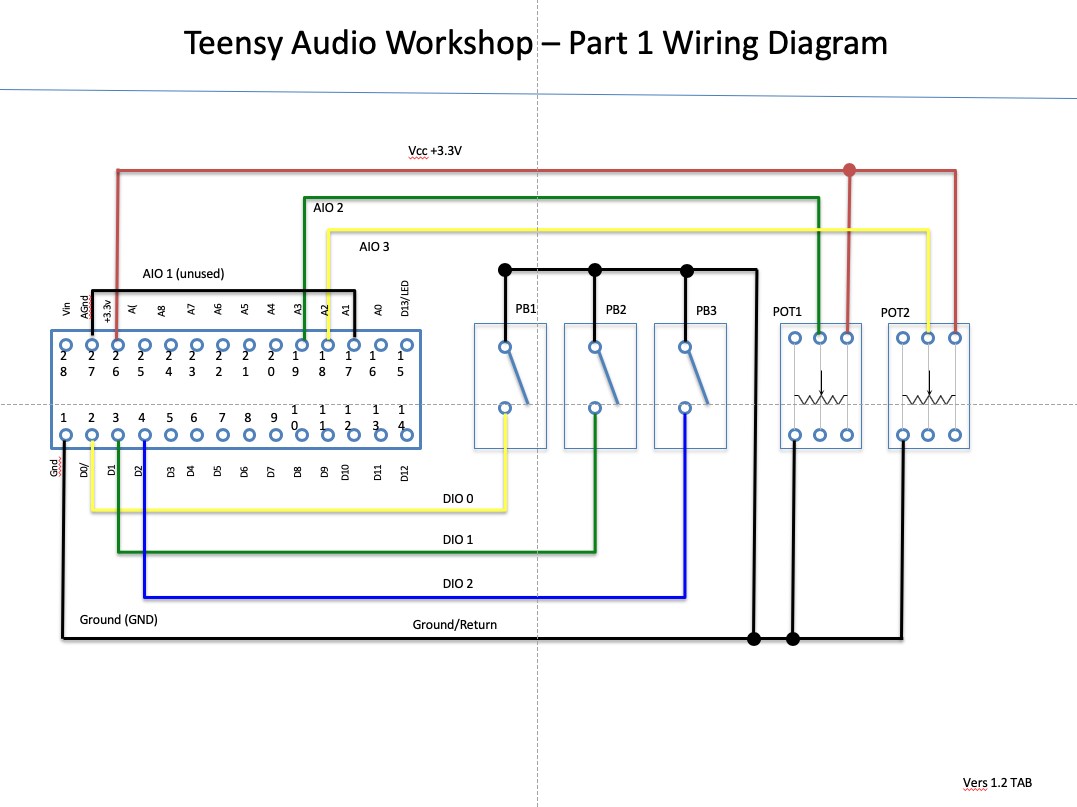
Audio Shield Docs & Tools/Teensy Audio Workshop Tutorial/Audio Workshop Pt1 Wiring Diagram.png
