tbitson/Teensy-GEP/User Documentation/User Guide/Doc Resources/IMG_0628.jpeg

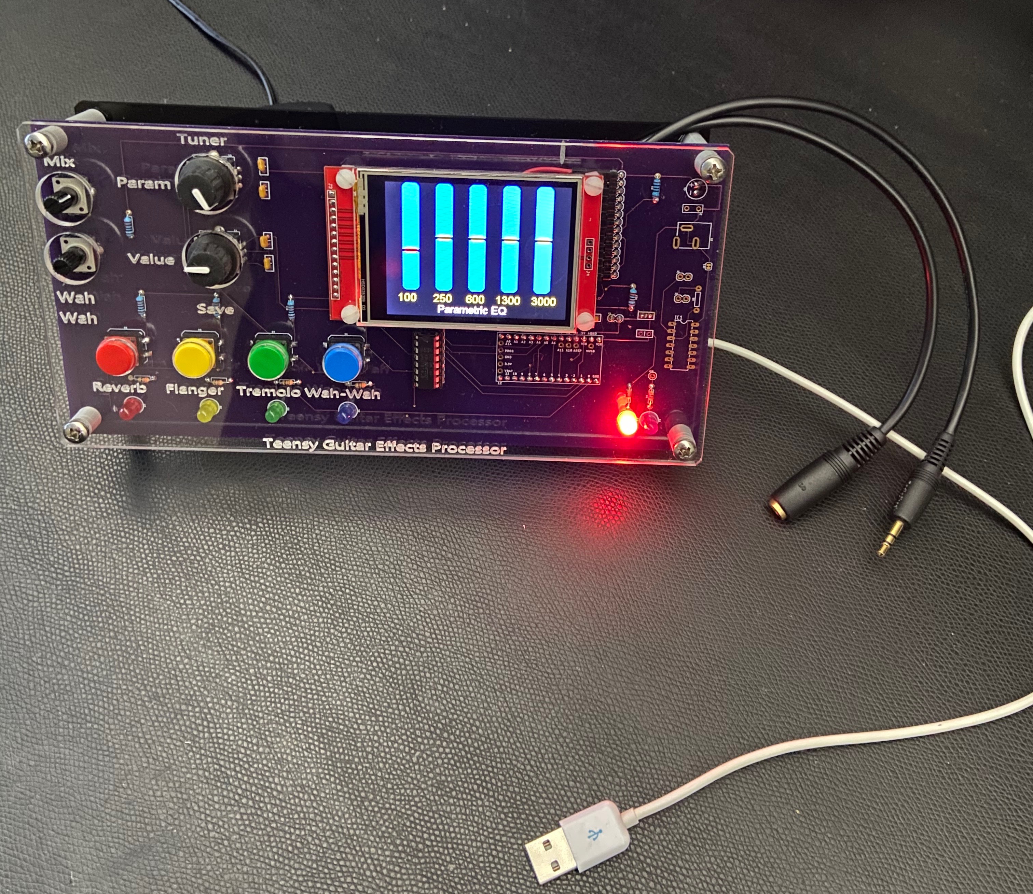
User Documentation/User Guide/Doc Resources/IMG_0628.jpeg
