tbitson/Teensy-GEP/User Documentation/User Guide/Doc Resources/IMG_0629.jpeg

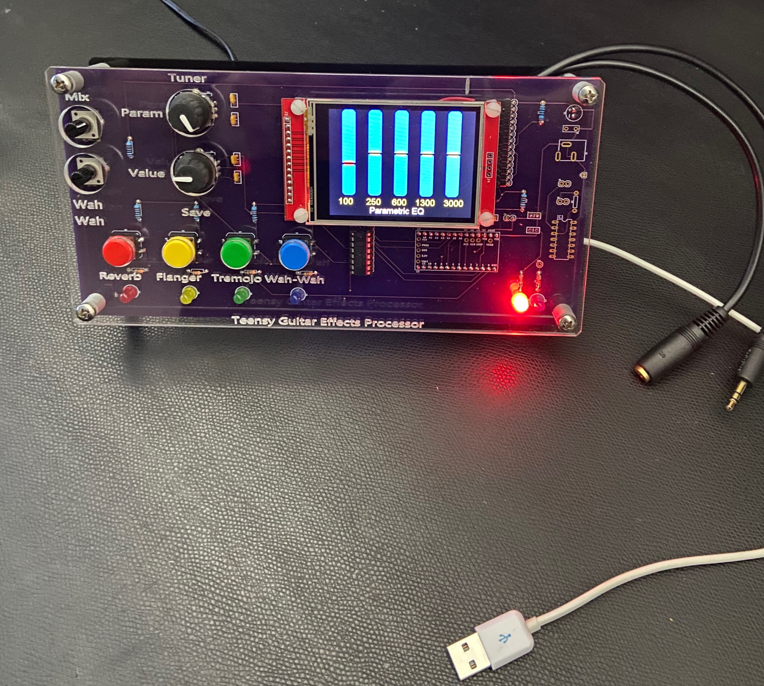
User Documentation/User Guide/Doc Resources/IMG_0629.jpeg
