tbitson/Teensy-GEP/User Documentation/User Guide/Doc Resources/IMG_0634D.jpeg

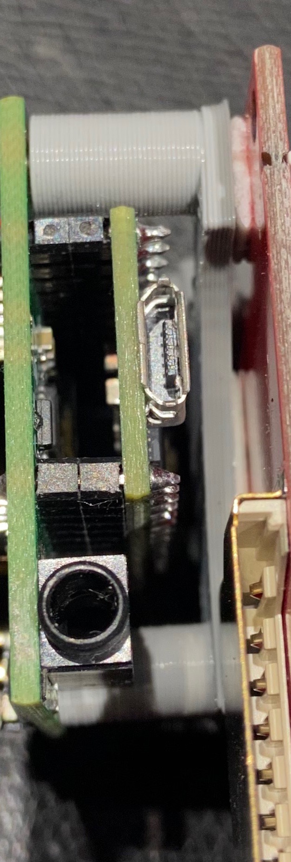
User Documentation/User Guide/Doc Resources/IMG_0634D.jpeg
