tbitson/Teensy-GEP/User Documentation/User Guide/Doc Resources/IMG_0639D 2.jpeg

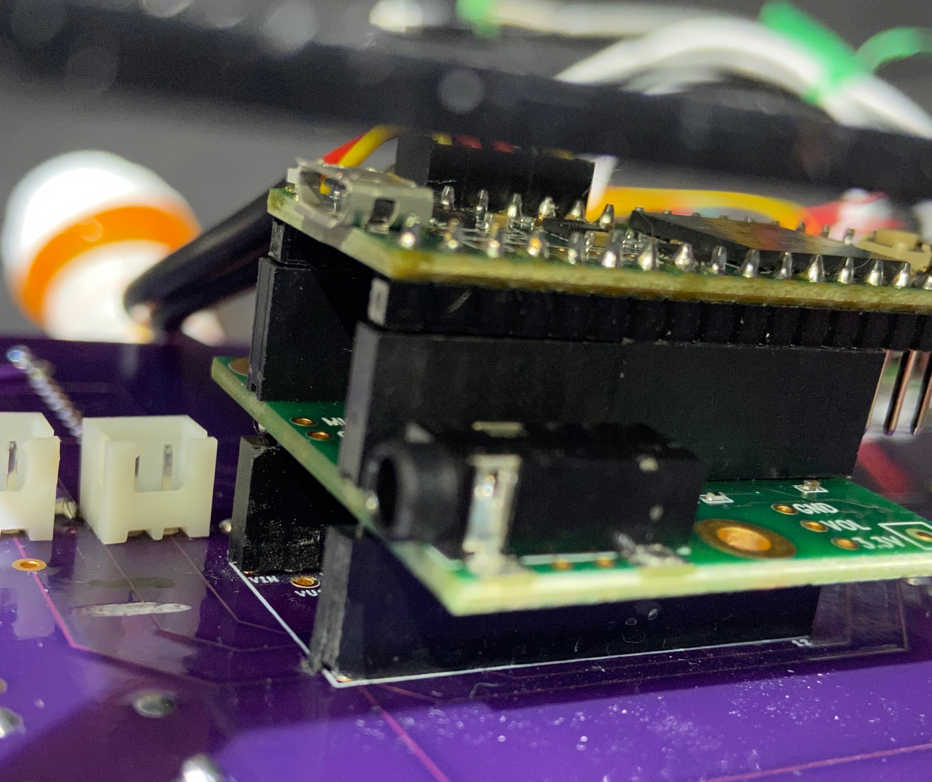
User Documentation/User Guide/Doc Resources/IMG_0639D 2.jpeg
