tbitson/Teensy-GEP/User Documentation/User Guide/Doc Resources/IMG_0639D.jpeg

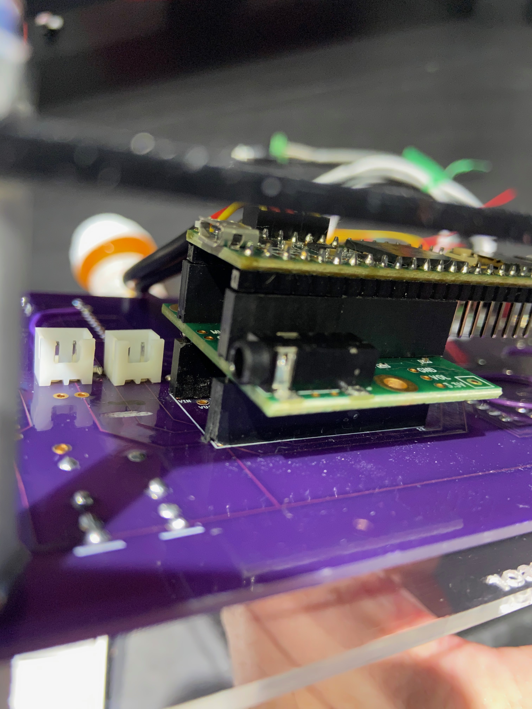
User Documentation/User Guide/Doc Resources/IMG_0639D.jpeg
