tbitson/Teensy-GEP/GEP Software/Support Files/Effects Development/mixer8_test/8-Channel Mixer Patches.png

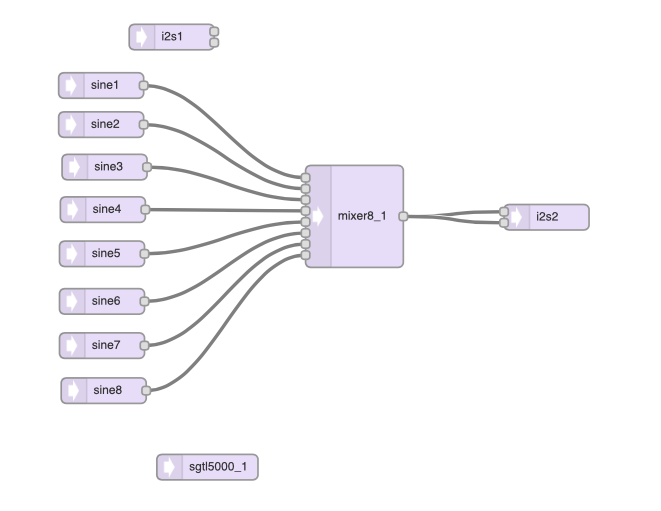
GEP Software/Support Files/Effects Development/mixer8_test/8-Channel Mixer Patches.png
