tbitson/Teensy-GEP/GEP Software/Support Files/Effects Development/Test_bitcrusher/Bitcrusher Test Patches.png

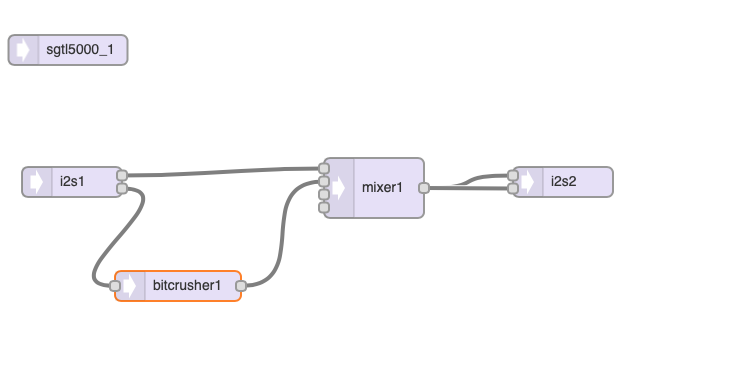
GEP Software/Support Files/Effects Development/Test_bitcrusher/Bitcrusher Test Patches.png
