tbitson/Teensy-GEP/GEP Software/Support Files/Effects Development/Test_Delay/Delay Test Patches.png

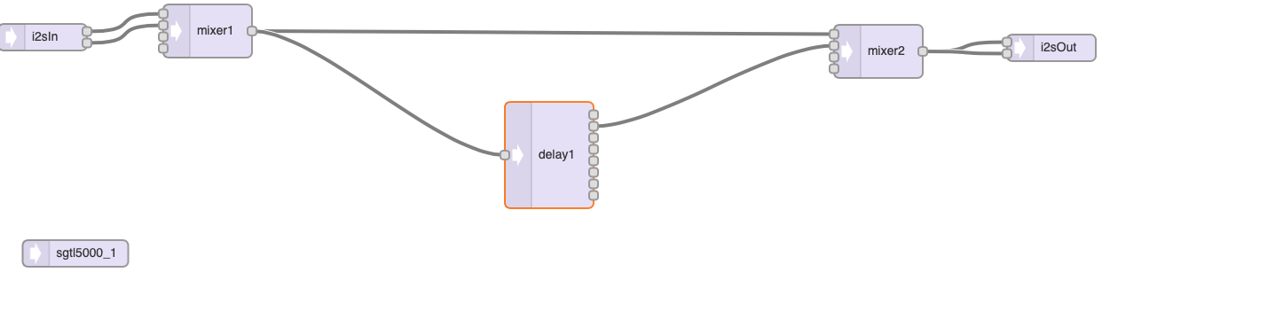
GEP Software/Support Files/Effects Development/Test_Delay/Delay Test Patches.png
