tbitson/Teensy-GEP/GEP Software/Support Files/Effects Development/Test_Delay_Ext_Mem/Test Ext Delay Patches.png

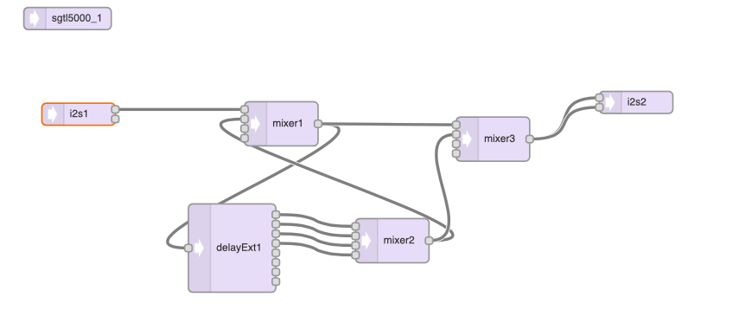
GEP Software/Support Files/Effects Development/Test_Delay_Ext_Mem/Test Ext Delay Patches.png
