tbitson/Teensy-GEP/GEP Software/Support Files/Effects Development/Test_freeverb/freeverb patches.png

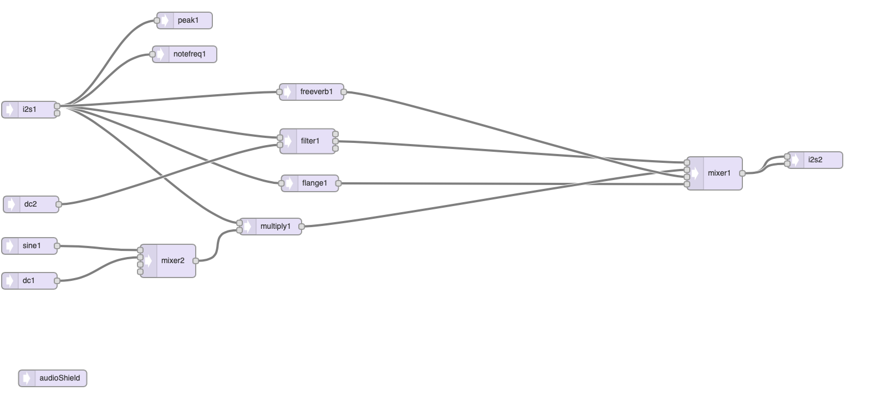
GEP Software/Support Files/Effects Development/Test_freeverb/freeverb patches.png
