tbitson/Teensy-GEP/GEP Software/Support Files/Effects Development/Test_Mid_Side/midside demo patches.png

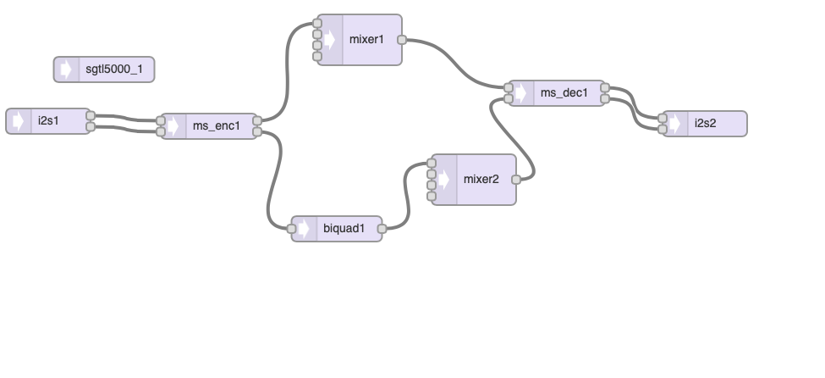
GEP Software/Support Files/Effects Development/Test_Mid_Side/midside demo patches.png
