tbitson/Teensy-GEP/GEP Hardware/Hardware Design Files/Teensy and Audio Board/Teensy Audio Board Mechanical.pdf

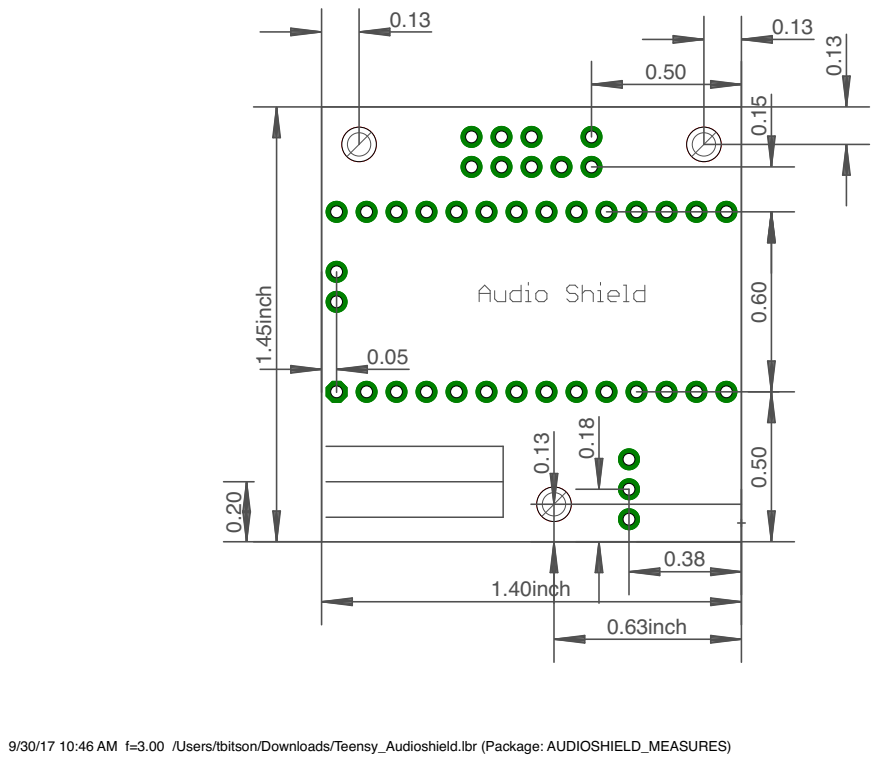
[picture p95: page 1]

9/30/17 10:46 AM f=3.00 /Users/tbitson/Downloads/Teensy_Audioshield.lbr (Package: AUDIOSHIELD_MEASURES)
