tbitson/Teensy-GEP/GEP Hardware/Hardware Design Files/Eagle Files/GEP Main Board V1.0.brd

## EAGLE design GEP Hardware/Hardware Design Files/Eagle Files/GEP Main Board V1.0.brd (2020-09-07)

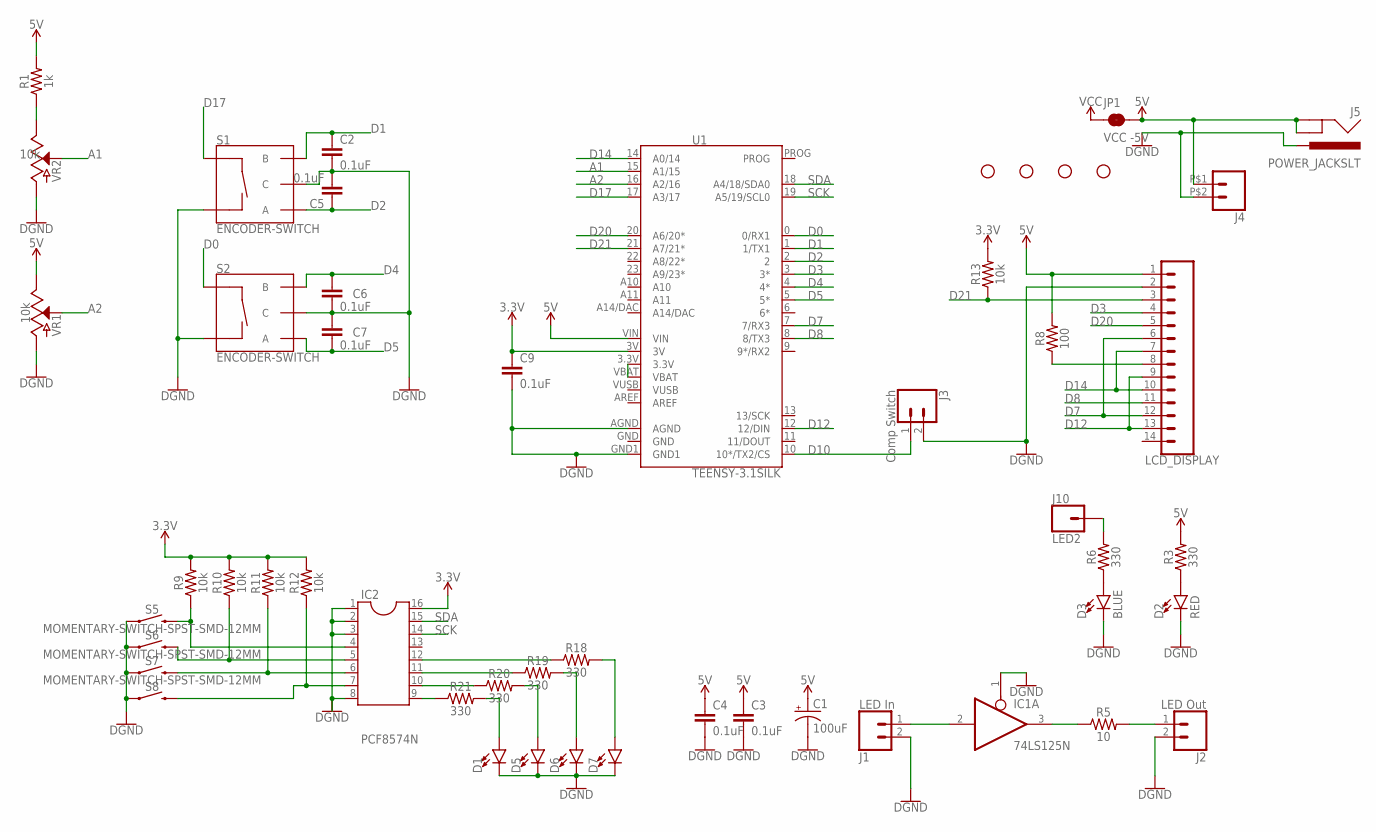
[picture p96: schematic GEP Main Board V1.0.sch]

Parts:
C1: 100uF; CPOL-RADIAL-2.5MM-6.5MM
C2, C3, C4, C5, C6, C7, C9: 0.1uF; CAP-PTH-SMALL-KIT
D1, D5, D6, D7: LED5MM; LED_5MM
D2: RED; LED_5MM
D3: BLUE; LED_5MM
H1, H2, H3, H4: STAND-OFF
IC1: 74LS125N; DIL14
IC2: PCF8574N; SOCKET-16
J1: LED In; 1X02
J2: LED Out; 1X02
J3: Comp Switch; 1X02
J4: CONN_02PTH2; 1X02_BIG
J5: POWER_JACKSLT; POWER_JACK_SLOT
J10: LED2; 1X01
JP1: VCC -5V; SMT-JUMPER_2_NC_TRACE_SILK
LCDDISPLAY: LCD_DISPLAY; 1X14
R1: 1k; AXIAL-0.3
R3, R6, R18, R19, R20, R21: 330; AXIAL-0.3
R5: 10; AXIAL-0.3
R8: 100; AXIAL-0.3
R9, R10, R11, R12, R13: 10k; AXIAL-0.3
S1, S2: ENCODER-SWITCH; ROTARY_ENC_PLAIN
S5, S6, S7, S8: MOMENTARY-SWITCH-SPST-SMD-12MM; TACTILE_SWITCH_SMD_12MM
U1: TEENSY-3.1SILK; TEENSY-3.1
VR1, VR2: 10k; POT-PTH-ALPS-KIT

Connections:
3.3V: C9.1, IC2.16, R9.P$2 (2), R10.P$2 (2), R11.P$2 (2), R12.P$2 (2), R13.P$2 (2), U1.3V
5V: C1.1 (+), C3.1, C4.1, J4.P$1 (1), J5.GND@1 (GNDBREAK), J5.GND@2 (GND), JP1.2, LCDDISPLAY.1, R1.P$2 (2), R3.P$2 (2), R8.P$2 (2), U1.VIN, VR1.P$1 (E)
A1: U1.15 (A1/15), VR2.P$2 (S)
A2: U1.16 (A2/16), VR1.P$2 (S)
D0: S2.SW+, U1.0 (0/RX1)
D1: C2.1, S1.B, U1.1 (1/TX1)
D2: C5.1, S1.A, U1.2
D3: LCDDISPLAY.4, U1.3 (3*)
D4: C6.1, S2.B, U1.4 (4*)
D5: C7.2, S2.A, U1.5 (5*)
D7: LCDDISPLAY.6, LCDDISPLAY.12, U1.7 (7/RX3)
D8: LCDDISPLAY.11, U1.8 (8/TX3)
D10: J3.1, U1.10 (10*/TX2/CS)
D12: LCDDISPLAY.9, LCDDISPLAY.13, U1.12 (12/DIN)
D14: LCDDISPLAY.7, LCDDISPLAY.10, U1.14 (A0/14)
D17: S1.SW+, U1.17 (A3/17)
D20: LCDDISPLAY.5, U1.20 (A6/20*)
D21: LCDDISPLAY.3, R13.P$1 (1), U1.21 (A7/21*)
GND: C1.2 (-), C2.2, C3.2, C4.2, C5.2, C6.2, C7.1, C9.2, D1.K (C), D2.K (C), D3.K (C), D5.K (C), D6.K (C), D7.K (C), IC1.1 (OE), IC1.7 (GND), IC2.1, IC2.2, IC2.3, IC2.8, J1.2, J2.2, J3.2, J4.P$2 (2), J5.PWR, LCDDISPLAY.2, S1.C, S1.SW-, S2.C, S2.SW-, S5.1, S6.1, S7.1, S8.1, U1.AGND, U1.GND, U1.GND1, VR1.P$3 (A), VR2.P$3 (A)
LED: LCDDISPLAY.8, R8.P$1 (1)
unnamed: U1.3.3V, U1.VBAT
unnamed: IC2.9, R21.P$1 (1)
unnamed: IC2.10, R20.P$1 (1)
unnamed: IC1.2 (I), J1.1
unnamed: IC1.3 (O), R5.P$1 (1)
unnamed: R1.P$1 (1), VR2.P$1 (E)
unnamed: D3.A, R6.P$1 (1)
unnamed: D2.A, R3.P$1 (1)
unnamed: IC2.5, R10.P$1 (1), S6.3 (2)
unnamed: IC2.6, R11.P$1 (1), S7.3 (2)
unnamed: IC2.7, R12.P$1 (1), S8.3 (2)
unnamed: IC2.4, R9.P$1 (1), S5.3 (2)
unnamed: J2.1, R5.P$2 (2)
unnamed: IC2.11, R19.P$1 (1)
unnamed: IC2.12, R18.P$1 (1)
unnamed: D1.A, R21.P$2 (2)
unnamed: D5.A, R20.P$2 (2)
unnamed: D6.A, R19.P$2 (2)
unnamed: D7.A, R18.P$2 (2)
unnamed: J10.1, R6.P$2 (2)
SCK: IC2.14, U1.19 (A5/19/SCL0)
SDA: IC2.15, U1.18 (A4/18/SDA0)
VCC: IC1.14 (VCC), JP1.1
VUSB: U1.VUSB

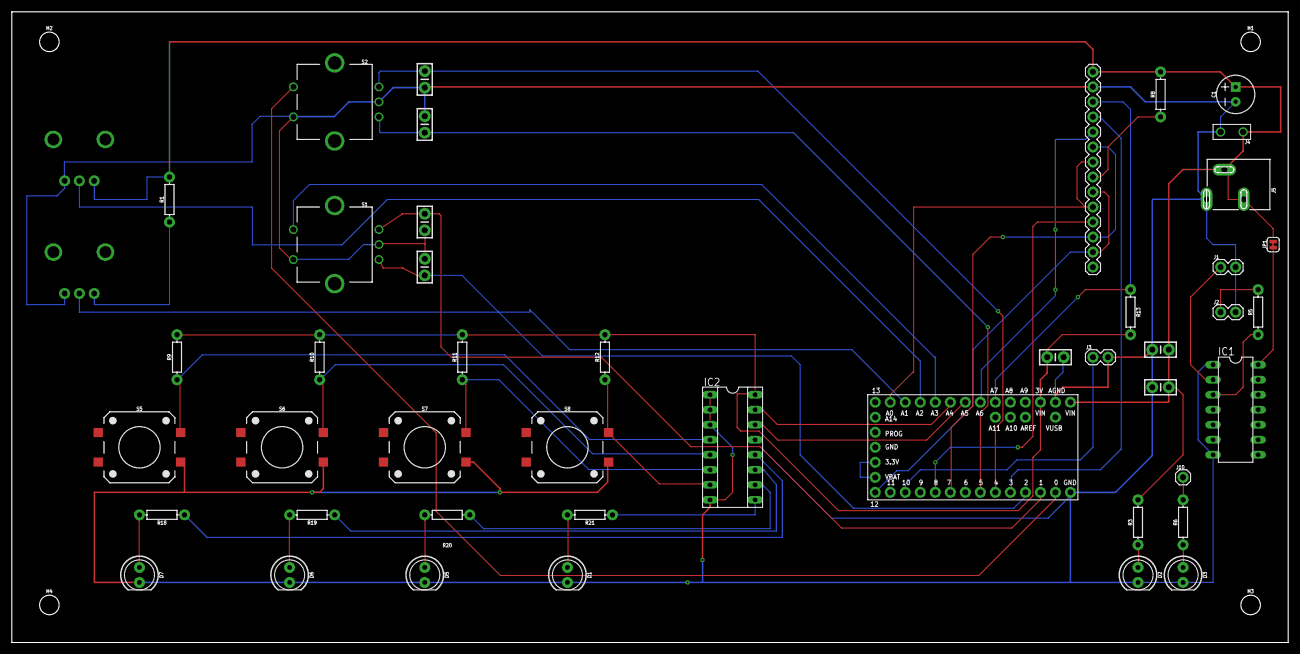
[picture p97: board GEP Main Board V1.0.brd from above]

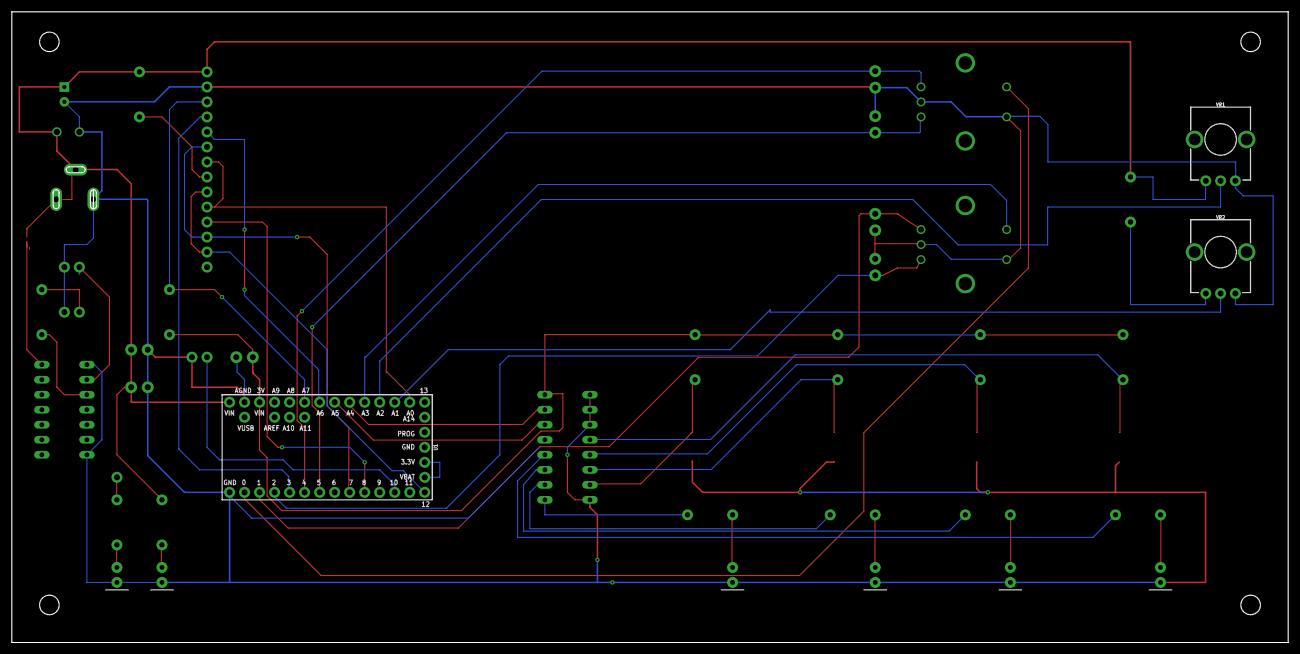
[picture p98: board GEP Main Board V1.0.brd from below]

Board: 2 copper layers, 215.9 x 106.7 mm, 51 parts (3 on the bottom side), 43 nets.
