tbitson/Teensy-GEP/GEP Hardware/Hardware Design Files/Rotary Encoder/Encoder_Test_2/Encoder_Test_2.ino

/* Encoder Library - Basic Example
 * http://www.pjrc.com/teensy/td_libs_Encoder.html
 *
 * This example code is in the public domain.
 */

#include <Encoder.h>



// Change these two numbers to the pins connected to your encoder.
//   Best Performance: both pins have interrupt capability
//   Good Performance: only the first pin has interrupt capability
//   Low Performance:  neither pin has interrupt capability
//   avoid using pins with LEDs attached
Encoder myEnc(5, 6);

long oldPosition  = -999;



void setup() 
{
  Serial.begin(9600);
  Serial.println("Basic Encoder Test:");
}



void loop() 
{
  long newPosition = myEnc.read();
  if (newPosition != oldPosition) 
  {
    oldPosition = newPosition;
    Serial.println(newPosition);
  }
}
