tbitson/Teensy-GEP/(commit log)

2020-09-07 Initial Release 1.8
    Version 1.8 full release
    [GEP Main Board V1.0.brd, GEP Main Board V1.0.sch, GEP Teeny IO Functions.xlsx, Teensy Audio Pin Map.xlsx, Teensy IO Functions.xlsx, Teensy Pinout Comparison.xlsx]
2020-10-01 Bug Fixes
    Updated AVC code to use the Audio Lib fix (Compressor now wroks!), fixed boot hang issue, cleanup
    [OpenAudio_Compressor_Test.ino, PZ_Compressor.ino, Pass-Thru.ino, Test_Compressor.ino, Test_Delay.ino.ino]
